sluitz/UTI-Teensy-v2/README.md

# UTI-Teensy-v2

PCB designs, Teensy code, and PCB enclosure designs for a UTI- and Teensy 4.1-based cryogenic-temperature-compatible liquid-level sensor.
