sluitz/UTI-Teensy-v2/pcb_enclosure.step

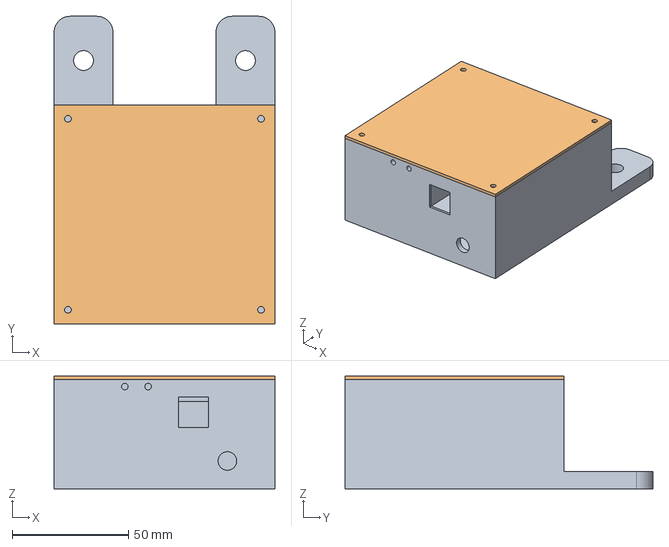
[picture p1: CAD file, 2022-12-14]
pcb_enclosure.step
95.0 x 132.2 x 48.5 mm
