sluitz/UTI-Teensy-v2/(list of files, cad)

Other CAD files:
pcb_enclosure.f3d
