sluitz/UTI-Teensy-v2/(list of files, drawings)

Other design files:
kicad_pcb/UTI-Teensy-v2.dsn
