sluitz/UTI-Teensy-v2/kicad_pcb/UTI-Teensy-v2.kicad_pcb

## KiCad design kicad_pcb/UTI-Teensy-v2.kicad_pcb (2022-12-02)

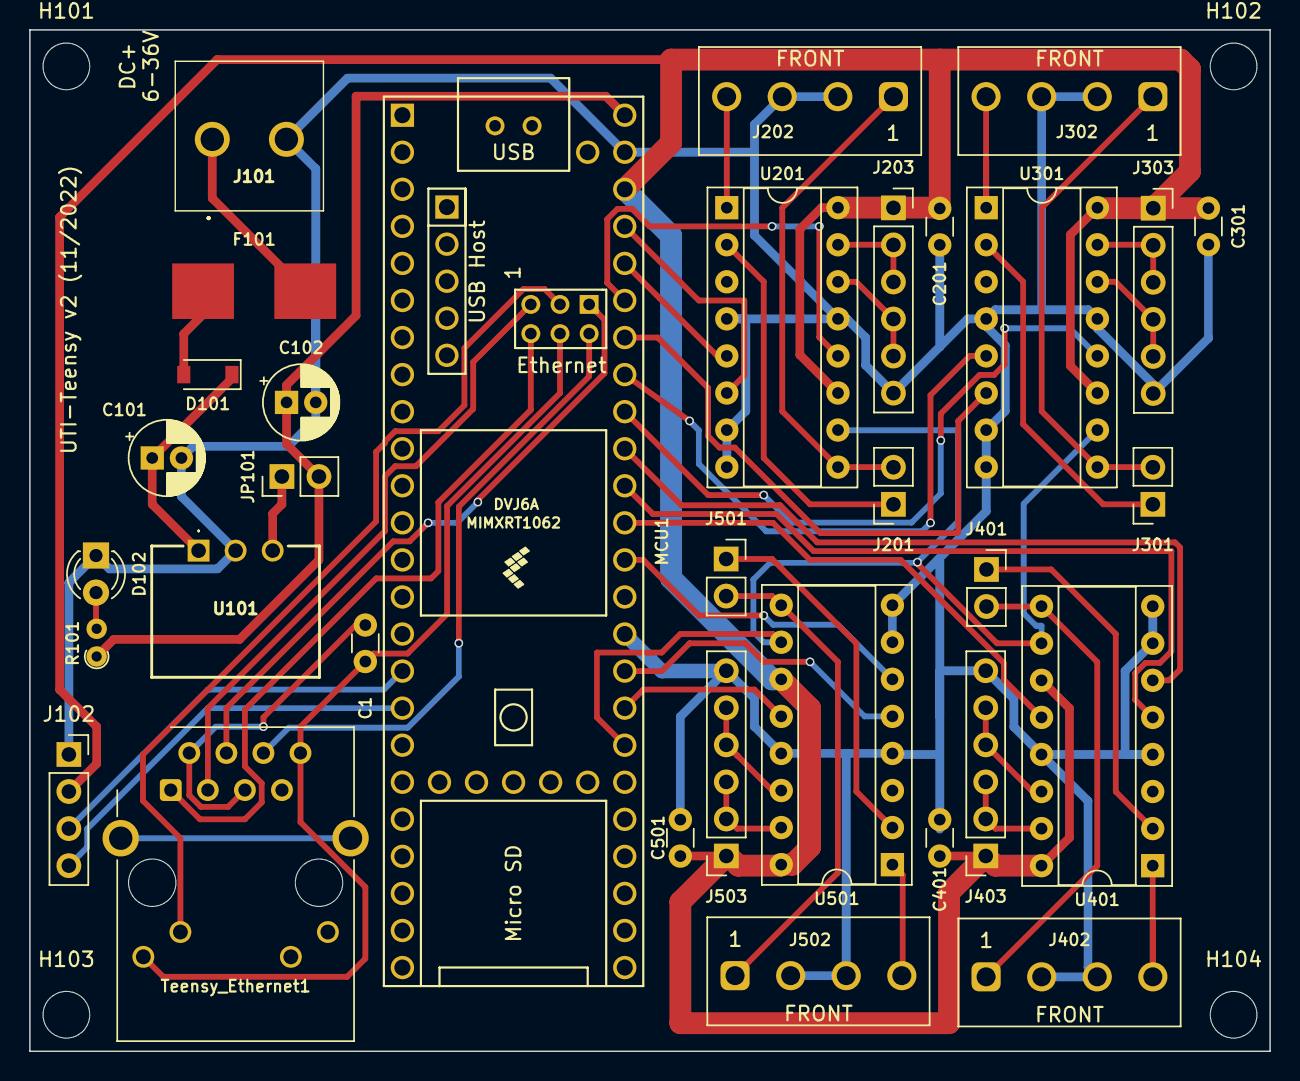
[picture p2: board UTI-Teensy-v2.kicad_pcb from above]

Board: 2 copper layers, 85.0 x 70.0 mm, 37 parts (0 on the bottom side), 50 nets.

Parts:
C1: 0.1uF1; C_Disc_D3.0mm_W1.6mm_P2.50mm
C101: 10u; CP_Radial_D5.0mm_P2.00mm
C102: 22u; CP_Radial_D5.0mm_P2.00mm
C201, C301, C401, C501: 0.1uF; C_Disc_D3.0mm_W1.6mm_P2.50mm
D101: D; D_SOD-123
D102: LED 5VOK; LED_D3.0mm
F101: 1A; smd_fuse
H101, H102, H103, H104: MountingHole; MountingHole_3.2mm_M3_DIN965
J101: PwrIn; TB00750802BE
J102: OLED Display I2C; PinSocket_1x04_P2.54mm_Vertical
J201, J301, J401, J501: Cref; PinSocket_1x02_P2.54mm_Vertical
J202, J302, J402, J502: C_x; Amphenol Anytech YO 3.81mm 4p
J203, J303, J403, J503: extR; PinSocket_1x06_P2.54mm_Vertical
JP101: PS; PinHeader_1x02_P2.54mm_Vertical
MCU1: Teensy4.1; Teensy41
R101: 330R; R_Axial_DIN0204_L3.6mm_D1.6mm_P1.90mm_Vertical
Teensy_Ethernet1: RJ45_LED; RJ45_Cetus_J1B1211CCD_Horizontal
U101: N7805; N78051C
U201, U301, U401, U501: UTI-DIL16; DIP-16_W7.62mm_Socket

Connections:
+3.3V: C201.1, C301.1, C401.1, C501.1, J102.2, J203.1, J303.1, J403.1, J503.1, MCU1.46 (3V3), U201.11 (PD), U201.16 (VDD), U301.11 (PD), U301.16 (VDD), U401.11 (PD), U401.16 (VDD), U501.11 (PD), U501.16 (VDD)
+5V: C102.1, JP101.2 (B), MCU1.48 (VIN), R101.1
+6-36V: F101.2, J101.1
/UTI+Connectors1/OUT: MCU1.43 (21_A7_RX5_BCLK1), U201.12 (OUT)
/UTI+Connectors1/SEL2: MCU1.44 (22_A8_CTX1), U201.5 (SEL2)
/UTI+Connectors1/SEL3: MCU1.45 (23_A9_CRX1_MCLK1), U201.6 (SEL3)
/UTI+Connectors2/OUT: MCU1.40 (18_A4_SDA), U301.12 (OUT)
/UTI+Connectors2/SEL2: MCU1.41 (19_A5_SCL), U301.5 (SEL2)
/UTI+Connectors2/SEL3: MCU1.42 (20_A6_TX5_LRCLK1), U301.6 (SEL3)
/UTI+Connectors3/OUT: MCU1.37 (15_A1_RX3_SPDIF_IN), U401.12 (OUT)
/UTI+Connectors3/SEL2: MCU1.38 (16_A2_RX4_SCL1), U401.5 (SEL2)
/UTI+Connectors3/SEL3: MCU1.39 (17_A3_TX4_SDA1), U401.6 (SEL3)
/UTI+Connectors4/OUT: MCU1.32 (40_A16), U501.12 (OUT)
/UTI+Connectors4/SEL2: MCU1.33 (41_A17), U501.5 (SEL2)
/UTI+Connectors4/SEL3: MCU1.36 (14_A0_TX3_SPDIF_OUT), U501.6 (SEL3)
GND: C101.2, C102.2, C201.2, C301.2, C401.2, C501.2, D102.1 (K), J101.2, J102.1, J202.2, J202.3, J203.6, J302.2, J302.3, J303.6, J402.2, J402.3, J403.6, J502.2, J502.3, J503.6, MCU1.34 (GND), MCU1.47 (GND), U101.2 (GND/-Vout), U201.4 (SEL1), U201.7 (SEL4), U201.8 (VSS), U201.13 (CML), U301.4 (SEL1), U301.7 (SEL4), U301.8 (VSS), U301.13 (CML), U401.4 (SEL1), U401.7 (SEL4), U401.8 (VSS), U401.13 (CML), U501.4 (SEL1), U501.7 (SEL4), U501.8 (VSS), U501.13 (CML)
I2C_SCL: J102.3, MCU1.16 (24_A10_TX6_SCL2)
I2C_SDA: J102.4, MCU1.17 (25_A11_RX6_SDA2)
unnamed: C1.1, Teensy_Ethernet1.2, Teensy_Ethernet1.5
unnamed: C1.2, MCU1.64 (GND), Teensy_Ethernet1.8, Teensy_Ethernet1.9
unnamed: C101.1, D101.1 (K), U101.1 (IN)
unnamed: D101.2 (A), F101.1
unnamed: D102.2 (A), R101.2
unnamed: J201.1, U201.2 (C)
unnamed: J201.2, J202.1, U201.9 (A)
unnamed: J202.4, U201.1 (D)
unnamed: J203.2, J203.3, U201.15 (E)
unnamed: J203.4, J203.5, U201.14 (F)
unnamed: J301.1, U301.2 (C)
unnamed: J301.2, J302.1, U301.9 (A)
unnamed: J302.4, U301.1 (D)
unnamed: J303.2, J303.3, U301.15 (E)
unnamed: J303.4, J303.5, U301.14 (F)
unnamed: J401.1, U401.2 (C)
unnamed: J401.2, J402.1, U401.9 (A)
unnamed: J402.4, U401.1 (D)
unnamed: J403.2, J403.3, U401.15 (E)
unnamed: J403.4, J403.5, U401.14 (F)
unnamed: J501.1, U501.2 (C)
unnamed: J501.2, J502.1, U501.9 (A)
unnamed: J502.4, U501.1 (D)
unnamed: J503.2, J503.3, U501.15 (E)
unnamed: J503.4, J503.5, U501.14 (F)
unnamed: JP101.1 (A), U101.3 (+Vout/GND)
unnamed: MCU1.60 (R+), Teensy_Ethernet1.4
unnamed: MCU1.61 (LED), Teensy_Ethernet1.10
unnamed: MCU1.62 (T-), Teensy_Ethernet1.3
unnamed: MCU1.63 (T+), Teensy_Ethernet1.1
unnamed: MCU1.65 (R-), Teensy_Ethernet1.6
SF: MCU1.31 (39_MISO1_OUT1A), U201.10 (SF), U301.10 (SF), U401.10 (SF), U501.10 (SF)
