sluitz/UTI-Teensy-v2/(commit log)

2022-12-02 UTI-Teensy-v2 initial commit
    [UTI+Connectors.kicad_sch, UTI-Teensy-v2.dsn, UTI-Teensy-v2.kicad_pcb, UTI-Teensy-v2.kicad_sch]
2022-12-06 Update read-uti-teensy-interrupt.ino
    lots of changes, primarily for outputting more values to modbus and removing hardcoded constants.
2022-12-08 Enclosure for the PCB
    The design files for an enclosure for the PCB, courtesy of Marshall Johnson. (Uploaded with permission.)
    [pcb_enclosure.step]
2022-12-08 PCB Enclosure, courtesy of Marshall Johnson
    [pcb_enclosure.f3d]
2022-12-09 Update read-uti-teensy-interrupt.ino
    blink the LED a few times before starting
